huzi-ctrl/Verticality/TEACHER_REQUISITION.md

# School Purchase Requisition: CanSat Mission Components

**Project:** CanSat High-Altitude Scientific Investigation (Dual-Chamber Bioluminescence Experiment)  
**Student Name:** CanSat Project Lead  
**Institution:** Lancaster University School of Mathematics (LUSoM) Lab & D&T Department  
**Purpose:** Requisition for live biological science payload and flight electronics/hardware (excluding custom PCB fabrication).

---

## 1. Summary of Orders for School Approval

| Order | Supplier | Items Included | Total (ex. VAT) | Total (inc. VAT & Delivery) |
| :--- | :--- | :--- | :---: | :---: |
| **Order A** | **Darwin Biological UK** | Living *Pyrocystis* Algae Starter Culture + Marine Growth Medium Vial | **£32.50** | **£39.00** |
| **Order B** *(Option 1)* | **LCSC Electronics** | 7 Hand-Fit Electronics (LoRa Radio, 3.3V LDO, Battery Headers, Antenna, Switch, Heater) | **£18.41** | **£22.09** |
| **Order B** *(Option 2)* | **UK Hardware / Amazon** | Mechanical Airframe & Parachute Recovery (M3 Tie-Rods, Lifting Eye Bolt, Parachute Fabric, Swivels, Servo) | **£22.78** | **£22.78** |

*Note for School Finance: UK educational institutions reclaim VAT on educational/lab supplies (under Section 33 of the VAT Act 1994), so Darwin Biological net cost to the school department is £32.50.*

---

## Order A: Darwin Biological UK (Live Science Payload)
* **Supplier:** Darwin Biological UK ([darwinbiological.co.uk](https://www.darwinbiological.co.uk))
* **Supplier Type:** UK Educational & Laboratory Biology Supplier (accepts school purchase orders / card)
* **Delivery Method:** Temperature-controlled tracked living culture courier

### Itemized Breakdown:

| # | Item Description | Qty | Unit Price (ex. VAT) | Total Price (ex. VAT) | Direct Supplier Link |
| :-: | :--- | :-: | :-: | :-: | :--- |
| **1** | **Pyrocystis lunula Live Algae Starter Culture**<br>*Bioluminescent marine dinoflagellate algae in sterile culture flask. Primary test organism for measuring shear stress and gravity-induced luminescence response during flight.* | 1 | £17.85 | £17.85 | [Darwin Biological Direct Link](https://www.darwinbiological.co.uk/products/pyrocystis-lunula?variant=39852527976623) |
| **2** | **Marine Algae Growth Medium Vial (Makes 1 Litre)**<br>*Concentrated F/2 enrichment nutrient solution. Diluted into sterile seawater to maintain and culture the Pyrocystis stock in the school lab before and after the flight.* | 1 | £7.15 | £7.15 | [Darwin Biological Direct Link](https://www.darwinbiological.co.uk/products/marine-algae-growth-medium?variant=42611785892015) |
| **3** | **Live Culture Tracked Courier Delivery**<br>*Mandatory temperature-controlled tracked 24-hour delivery for live cultures.* | 1 | £7.50 | £7.50 | [Darwin Biological Checkout](https://www.darwinbiological.co.uk) |

* **Order A Subtotal (ex. VAT):** **£32.50**
* **20% UK VAT:** £6.50
* **Order A Grand Total (inc. VAT & Delivery):** **£39.00**

---

## Order B (Option 1): LCSC Electronics Basket (£22.09 Total)
* **Supplier:** LCSC Electronics ([lcsc.com](https://www.lcsc.com))
* **Purpose:** The 7 through-hole/hand-soldered electronics components that plug into the CanSat PCB for radio telemetry, power regulation, battery connection, and biological chamber thermal regulation.
* **Format:** Single basket with all items shipped together in one package.

### Itemized Breakdown:

| # | Item Description | Qty | Unit Price (GBP) | Total Price (GBP) | LCSC Part # | Direct Purchasing Link |
| :-: | :--- | :-: | :-: | :-: | :---: | :--- |
| **1** | **Ai-Thinker Ra-02 SX1278 433 MHz LoRa Radio Module**<br>*Long-range telemetry transmitter sending sensor data (altitude, temperature, light levels, acceleration) to ground station.* | 1 | £5.33 | £5.33 | `C90039` | [LCSC C90039](https://www.lcsc.com/product-detail/C90039.html) |
| **2** | **Microchip MCP1700-3302E/TO 3.3V 250mA LDO Regulator**<br>*Low-dropout TO-92 linear voltage regulator providing clean 3.3V power to the microcontroller and sensors.* | 1 | £0.81 | £0.81 | `C511277` | [LCSC C511277](https://www.lcsc.com/product-detail/C511277.html) |
| **3** | **100 µF 16V Radial Electrolytic Capacitor (D5×L7 mm)**<br>*Bulk buffer capacitor preventing voltage sag during servo deployment (pack of 50; spares remain in school lab).* | 50 | £0.015 | £0.74 | `C43803` | [LCSC C43803](https://www.lcsc.com/product-detail/C43803.html) |
| **4** | **JST-PH 2.0 mm 2-Pin Shrouded Male Battery Header**<br>*Standard polarity connector for plugging in 3.7V flight battery (pack of 20; spares remain in school lab).* | 20 | £0.027 | £0.54 | `C131337` | [LCSC C131337](https://www.lcsc.com/product-detail/C131337.html) |
| **5** | **BAT Wireless 433 MHz Helical Spring Antenna (21 mm)**<br>*Compact helical antenna fitting inside top compartment for 433 MHz transmission (pack of 5).* | 5 | £0.111 | £0.55 | `C496554` | [LCSC C496554](https://www.lcsc.com/product-detail/C496554.html) |
| **6** | **SOFNG SS-12D00-G3 Sub-Miniature SPDT Slide Switch**<br>*Master flight power hardware toggle switch.* | 1 | £0.02 | £0.02 | `C22355741` | [LCSC C22355741](https://www.lcsc.com/product-detail/C22355741.html) |
| **7** | **Yageo 15 Ω 2W 5% Metal Film Axial Power Resistor**<br>*Heating element glued to Chamber A block to maintain biology at +22°C during high-altitude descent (pack of 10).* | 10 | £0.042 | £0.42 | `C176558` | [LCSC C176558](https://lcsc.com/product-detail/Through-Hole-Resistors_YAGEO-MFR2WSJT-73-15R_C176558.html) |
| **8** | **Standard Courier Shipping Allowance** | 1 | £10.00 | £10.00 | — | Standard tracked shipping |
| **9** | **UK 20% VAT on LCSC Order** | 1 | £3.68 | £3.68 | — | 20% UK import VAT |

* **Order B (LCSC Option) Total inc. VAT & Delivery:** **£22.09**

---

## Order B (Option 2): UK Airframe & Parachute Hardware (£22.78 Total)
* **Suppliers:** Amazon UK & eBay UK
* **Purpose:** Physical structure tie-rods, parachute canopy fabric, rigging swivels, deployment servo, and thermal sensors (alternative £20–£25 order if the school prefers ordering through UK suppliers / Amazon rather than LCSC).

### Itemized Breakdown:

| # | Item Description | Qty | Unit Price (GBP) | Total Price (GBP) | Supplier | Direct Purchasing Link |
| :-: | :--- | :-: | :-: | :-: | :--- | :--- |
| **1** | **M3 × 300 mm A2 Stainless Steel Allthread Rods (Pack of 2)**<br>*Cut into 3× 115 mm structural tie-rods clamping the 3-tier CanSat PETG airframe together.* | 1 | £3.70 | £3.70 | Amazon UK | [Amazon UK Link](https://amzn.eu/d/0aMMNgs8) |
| **2** | **M3 A2 Stainless Steel Lifting Eye Bolt**<br>*Structural top anchor transferring parachute opening shock load directly to the 3 steel tie-rods.* | 1 | £2.15 | £2.15 | eBay UK | [eBay UK Link](https://www.ebay.co.uk/itm/323003622859) |
| **3** | **Ripstop Nylon Fabric 0.5 m × 1.5 m (Bright Orange)**<br>*Lightweight ripstop fabric to construct the 38 cm octo-annular parachute canopy.* | 1 | £3.15 | £3.15 | eBay UK | [eBay UK Link](https://www.ebay.co.uk/itm/124789110629) |
| **4** | **Heavy-Duty Ball-Bearing Swivels Size 2/4 (Pack of 10)**<br>*35 kg test breaking strain swivels preventing parachute shroud lines from twisting during descent.* | 1 | £3.39 | £3.39 | eBay UK | [eBay UK Link](https://www.ebay.co.uk/itm/122172655412) |
| **5** | **TowerPro MG90S Micro Metal-Gear 180° Servo**<br>*Actuator mechanism to release the 3 spring-loaded landing legs before touchdown.* | 1 | £3.31 | £3.31 | eBay UK | [eBay UK Link](https://www.ebay.co.uk/itm/188944133546) |
| **6** | **10k Ω NTC High-Precision Thin-Film Thermistors (Pack of 2)**<br>*Precision temperature probes monitoring Chamber A (heated) and Chamber B (unheated) biology.* | 1 | £1.99 | £1.99 | eBay UK | [eBay UK Link](https://www.ebay.co.uk/itm/172602710821) |
| **7** | **TP4056 USB-C 1A Lithium Battery Charging Board**<br>*Benchtop USB-C LiPo charger with dual protection ICs for safe battery recharging in the lab.* | 1 | £1.70 | £1.70 | eBay UK | [eBay UK Link](https://www.ebay.co.uk/itm/900026123899) |
| **8** | **IPEX / U.FL to Female SMA / Pigtail Coaxial RF Cable**<br>*RF pigtail connecting the Ra-02 LoRa board to the antenna (£1.39 + £2.00 Royal Mail delivery).* | 1 | £3.39 | £3.39 | eBay UK | [eBay UK Link](https://www.ebay.co.uk/itm/283186629071) |

* **Order B (UK Hardware Option) Total inc. VAT & Delivery:** **£22.78**

---

## 2. School Lab & Workshop Free Stock Provided (£0.00)
The following materials will be sourced directly from existing school D&T workshop and science lab supplies at no extra expense:
1. **Sterile Seawater Base:** School biology lab supply (distilled water + 35 g/L aquarium marine salt).
2. **Growth Light & 12:12 Timer:** Standard school laboratory fluorescent/LED grow lamp.
3. **Specimen Vials & Syringes:** 5 ml sterile polycarbonate sample vials and transfer pipettes.
4. **3D-Printing Filament:** PETG and TPU filament from school D&T 3D printers for the outer cylindrical hull and 3 landing legs.
5. **Fasteners:** M3 stainless steel Nyloc lock nuts and M3 washers from workshop stock.
6. **Recovery Cordage:** 550 military-spec paracord for parachute bridle and shroud lines.
7. **Ballast:** Scrap steel washers/nuts (~62 g) mounted in the lower battery hatch to position center of gravity below the leg pivot plane.
