huzi-ctrl/Verticality/images/pcb_angled_3d.png

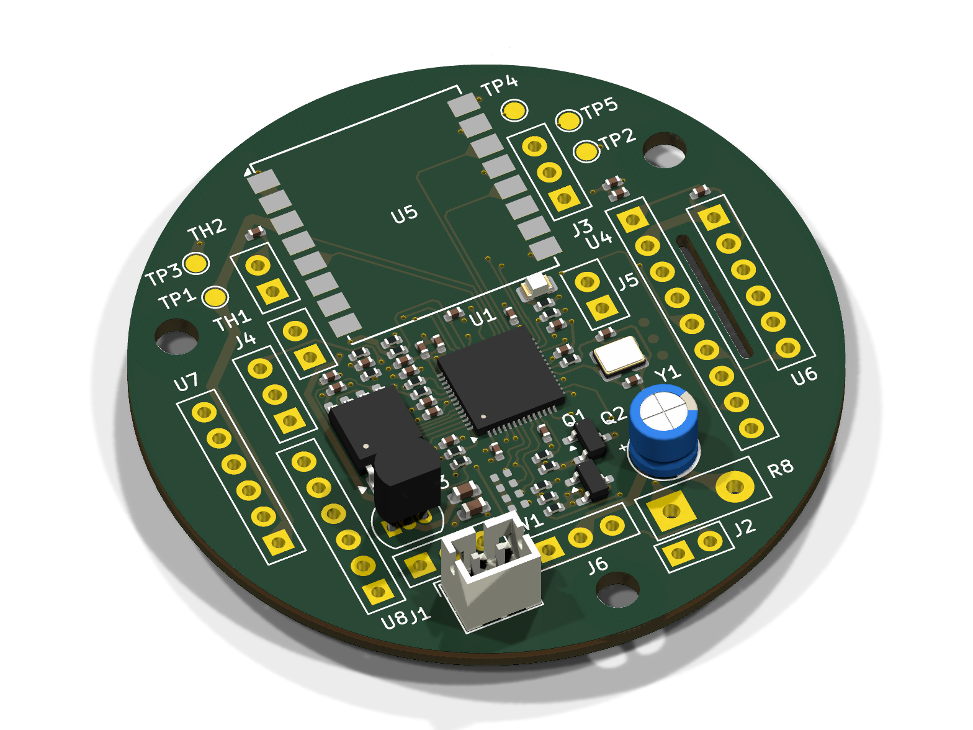
images/pcb_angled_3d.png
