huzi-ctrl/Verticality/images/pcb_bottom_3d.png

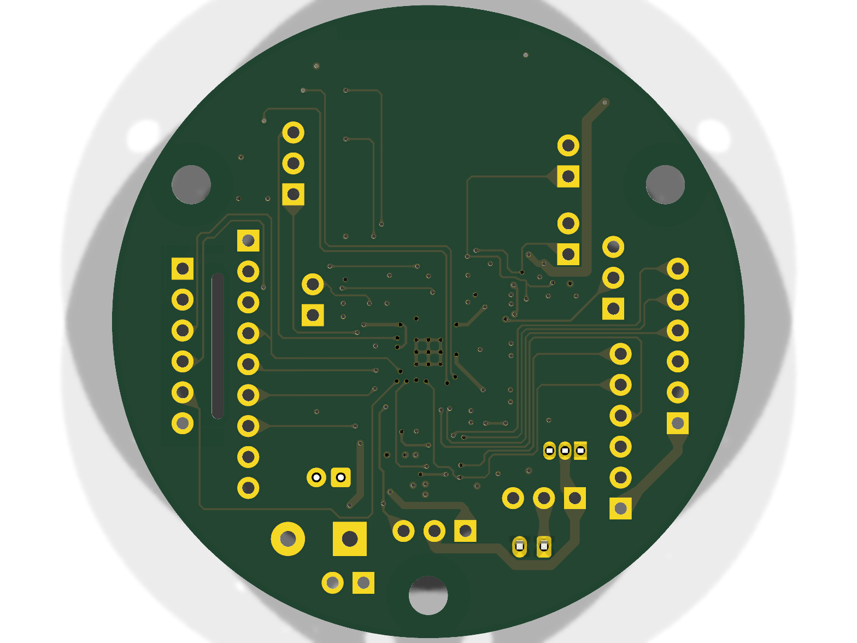
images/pcb_bottom_3d.png
