huzi-ctrl/Verticality/images/pcb_top_3d.png

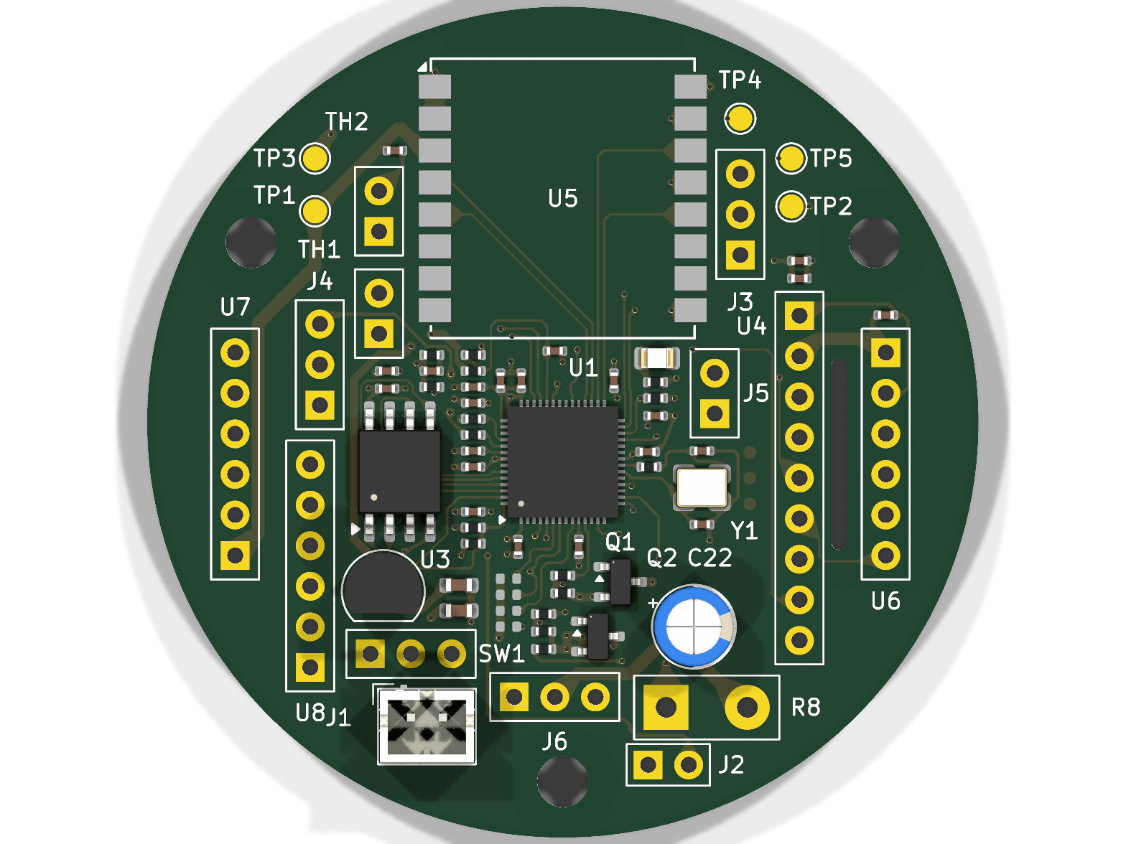
images/pcb_top_3d.png
