huzi-ctrl/Verticality/CanSat_parts_verified_direct_links.xlsx

Sheet: BOM
CanSat Team Verticality - complete BOM with real prices from your screenshots
Prices are the ones on your screenshots (LCSC in $, eBay/AliExpress in £). Yellow link cells = I have no exact URL: paste yours. Red status = a problem found on the page. Blue cells are editable and everything recalculates.
 | ASSUMPTIONS
 | FX £ per $ |  |  |  | 0.75
 | Assembled boards (JLCPCB min 2) |  |  |  | 2
 | VAT rate |  |  |  | 20%
 | SMT joints per board |  |  |  | 157
 | Extended-part allowance (unverified Basic parts) |  |  |  | 0
 | Accelerometer: 1 = ADXL375 chip placed by JLCPCB, 2 = ADXL345 module (±16 g), 3 = ADXL375 eBay module (hand-fit) |  |  |  | 3
 | Budget target £ |  |  |  | £150.00
 | TOTAL COST (inc VAT and delivery)
 | JLCPCB order |  |  |  | £40.41
 | LCSC hand-fit basket |  |  |  | £22.09
 | UK / overseas retail |  |  |  | £52.59
 | Biology |  |  |  | £39.00
 | GRAND TOTAL |  |  |  | £154.10
 | Over (+) / under (-) target |  |  |  | £4.10
 | Accelerometer options (total cost of each)
 | 1: ADXL375 chip placed by JLCPCB |  |  |  | £173.27
 | 2: ADXL345 module (±16 g, clips at landing) |  |  |  | £140.15
 | 3: ADXL375 module (±200 g, hand-fit) |  |  |  | £154.10
# | Order | Item | Part number / exact spec | Code | Type | Qty | Per | Total qty | Price seen | Cur | Unit £ | Line £ | Exact link | Status / problem found / note
ORDER 1 - JLCPCB: PCB + factory-assembled SMD parts (Economic assembly, top side only). Prices ex VAT.
1 | 1 JLCPCB | RP2040 MCU | RP2040 QFN-56 | C2040 | Extended | 1 | board | 2 | 1.09 | $ | £0.81 | £1.63 | LCSC C2040 (https://www.lcsc.com/product-detail/C2040.html) | OK: Extended (not Basic). Economic + Standard OK. JLCPCB cart price $1.0859 (LCSC is $0.69; assembly uses the JLCPCB price).
2 | 1 JLCPCB | QSPI flash 16 MB | W25Q128JVSIQ SOIC-8 | C97521 | Basic | 1 | board | 2 | 2.33 | $ | £1.75 | £3.49 | LCSC C97521 (https://www.lcsc.com/product-detail/C97521.html) | OK: SMT Basic, 167 in stock, JLCPCB cart $2.3271; LCSC $2.35 at qty 1. Check its PCBA type on the JLCPCB page.
3 | 1 JLCPCB | Crystal 12 MHz | YXC X322512MSB4SI 3225 | C9002 | Basic | 1 | board | 2 | 0.0954 | $ | £0.0716 | £0.14 | LCSC C9002 (https://www.lcsc.com/product-detail/C9002.html) | OK: Basic, 138,870 in stock. 20 pF load matched with 33 pF caps (C1562). Bridge R1 (1 kΩ) with 0 Ω if cold start at 4 °C is slow.
4 | 1 JLCPCB | Crystal load caps | FH 0402CG330J500NT 33 pF 50V C0G | C1562 | Basic | 2 | board | 4 | 0.0020 | $ | £0.0015 | £0.01 | JLCPCB C1562 / LCSC (https://www.lcsc.com/product-detail/C1562.html) | OK: Verified Basic (1.58M in stock on JLCPCB at $0.0020; LCSC C1562). Exact 33 pF match for 20 pF crystal (C9002).
5 | 1 JLCPCB | Resistor 1 kΩ | 0402 UNI-ROYAL 0402WGF1001TCE | C11702 | Basic | 3 | board | 6 | 0.0013 | $ | £0.0010 | £0.01 | LCSC C11702 (https://www.lcsc.com/product-detail/C11702.html) | OK: Basic, 22 M in stock.
6 | 1 JLCPCB | Decoupling 1 µF | 0402 CL05A105KA5NQNC 25V X5R | C52923 | Basic | 2 | board | 4 | 0.0063 | $ | £0.0047 | £0.02 | LCSC C52923 (https://www.lcsc.com/product-detail/C52923.html) | OK: Basic, 1.55 M in stock. SCHEMATIC AUDIT 7 Nov: qty 3 -> 2 (C13, C16).
7 | 1 JLCPCB | Decoupling 100 nF | 0402 CL05B104KO5NNNC 16V X7R | C1525 | Basic | 18 | board | 36 | 0.0031 | $ | £0.0023 | £0.08 | LCSC C1525 (https://www.lcsc.com/product-detail/C1525.html) | OK: Basic, 3.3 M in stock. SCHEMATIC AUDIT 7 Nov: qty 14 -> 18 (C1-C9, C14, C15, C18-C21, C23-C25).
8 | 1 JLCPCB | Bulk 10 µF | 0603 CL10A106KP8NNNC 10V X5R | C19702 | Basic | 2 | board | 4 | 0.0203 | $ | £0.0152 | £0.06 | LCSC C19702 (https://www.lcsc.com/product-detail/C19702.html) | OK: Basic, 1.66 M in stock. It is 0603, not 0805. SCHEMATIC AUDIT 7 Nov: qty 3 -> 2 (C12, C17).
9 | 1 JLCPCB | Resistor 10 kΩ | 0402 0402WGF1002TCE | C25744 | Basic | 5 | board | 10 | 0.0018 | $ | £0.0014 | £0.01 | JLCPCB C25744 (https://jlcpcb.com/partdetail/C25744) | OK: Verified Basic on direct JLCPCB product page (15.8M in stock at $0.0018; LCSC C25744). SCHEMATIC AUDIT 7 Nov: qty 8 -> 5 (R5, R6, R13, R14, R17).
10 | 1 JLCPCB | Resistor 4.7 kΩ | 0402 0402WGF4701TCE | C25900 | Basic | 0 | board | 0 | 0.0017 | $ | £0.0013 | £0.00 | LCSC C25900 (https://www.lcsc.com/product-detail/C25900.html) | OK: Basic, 8.8 M in stock. SCHEMATIC AUDIT 7 Nov: qty 4 -> 0. R18-R21 are DNP on the schematic (modules should carry their own I2C pull-ups). Hand-fit 0402 4.7k only if a module has none.
11 | 1 JLCPCB | Resistor 100 kΩ | 0402 0402WGF1003TCE | C25741 | Basic | 4 | board | 8 | 0.0013 | $ | £0.0010 | £0.01 | LCSC C25741 (https://www.lcsc.com/product-detail/C25741.html) | OK: Basic, 688 k in stock. Found it from your screenshots.
12 | 1 JLCPCB | Resistor 100 Ω (MOSFET gates) | 0402 0402WGF1000TCE | C25076 | Basic | 2 | board | 4 | 0.0012 | $ | £0.0009 | £0.0036 | LCSC C25076 (https://www.lcsc.com/product-detail/C25076.html) | OK: Basic, 7.9 M in stock.
13 | 1 JLCPCB | Resistor 22 Ω (USB series) | 0402 UNI-ROYAL 0402WGF220JTCE 22 Ω ±1% | C25092 | Basic | 2 | board | 4 | 0.0009 | $ | £0.0007 | £0.0027 | JLCPCB C25092 / LCSC (https://www.lcsc.com/product-detail/C25092.html) | OK: Verified Basic on JLCPCB (2.85M in stock at $0.0009; LCSC C25092). Standard RP2040 Full-Speed USB series termination. SCHEMATIC AUDIT 7 Nov: schematic R2/R3 are 27 ohm, BOM is 22 ohm. Change the schematic to 22 ohm, or switch this line to C25100 27 ohm (Extended, +about £2.76 with VAT).
14 | 1 JLCPCB | N-MOSFET (heater, servo) | AO3400A SOT-23 | C20917 | Basic | 2 | board | 4 | 0.0888 | $ | £0.0666 | £0.27 | JLCPCB C20917 (https://jlcpcb.com/partdetail/AO3400A/C20917) | OK: Basic, Economic + Standard (checked on JLCPCB).
15 | 1 JLCPCB | Light sensors (REMOVED from JLCPCB order) | Now 2 x TSL2591 breakout modules, wired (Row 76) | C176812 | n/a | 0 | board | 0 | 3.25 | $ | £2.44 | £0.00 |  | REMOVED: DFN chip is too small to hand-wire and carries a $3.07 Extended fee. Replaced by 2 x TSL2591 modules in Order 3 (Row 76). Do NOT add C176812 or C3678709 to the JLCPCB cart.
16 | 1 JLCPCB | Heater resistors (REMOVED from JLCPCB order) | Now one 15 ohm 2 W through-hole resistor from LCSC (Row 58) | C17471 | n/a | 0 | board | 0 | 0.0017 | $ | £0.0013 | £0.00 |  | REMOVED: the heater must sit against the Chamber A block, not on the top board. One 15 ohm 2 W resistor is wired to 2 pads on the main board; the AO3400A MOSFET stays on the board.
17 | 1 JLCPCB | Status LED green | KT-0805G 0805 | C2297 | Basic | 1 | board | 2 | 0.0164 | $ | £0.0123 | £0.02 | JLCPCB C2297 (https://jlcpcb.com/partdetail/C2297) | OK: Basic, Economic + Standard, 2.08 M in stock (checked on JLCPCB).
18 | 1 JLCPCB | High-g accelerometer (option 1) | ADXL375BCCZ-RL7 LGA-14 3x5 | C481898 | n/a | 0 | board | 0 | 20.44 | $ | £15.33 | £0.00 | LCSC C481898 (https://www.lcsc.com/product-detail/C481898.html) | OK (Inactive): Option 3 (UK eBay Adafruit ADXL375 breakout, Row 63) is selected in F9, bypassing JLCPCB placement.
19 | 1 JLCPCB | PCB panel: 5 bare 4-layer boards | ≤100x100 mm panel, 1.6 mm |  | Fixed | 1 | order | 1 | 5.96 | £ | £5.96 | £5.96 | JLCPCB quote (https://cart.jlcpcb.com/quote) | Fee: Live quote from the PDR (ex VAT).
20 | 1 JLCPCB | Assembly setup fee (Economic) | $8.18 |  | Fixed | 1 | order | 1 | 8.18 | $ | £6.13 | £6.13 |  | Fee: One-off.
21 | 1 JLCPCB | Stencil | $1.53 |  | Fixed | 1 | order | 1 | 1.53 | $ | £1.15 | £1.15 |  | Fee: One-off.
22 | 1 JLCPCB | SMT joints | $0.0016 per joint |  | Fixed | 314 | joint | 314 | 0.0016 | $ | £0.0012 | £0.38 |  | Fee: Joints/board x boards.
23 | 1 JLCPCB | Extended-part fees | $3.07 per unique Extended part |  | Fixed | 1 | part | 1 | 3.07 | $ | £2.30 | £2.30 |  | Fee: Counted from the Type column + allowance.
24 | 1 JLCPCB | JLCPCB shipping (assumed) | cheapest option at checkout |  | Fixed | 1 | order | 1 | 12.00 | £ | £12.00 | £12.00 | JLCPCB shipping (https://jlcpcb.com/help/article/shipping) | Fee: Standard checkout shipping allowance (£12 ex VAT).
25 | 1 JLCPCB | VAT on JLCPCB order | parts + fees + shipping |  | Fixed | 1 | order | 1 | 0.00 | £ | £0.00 | £6.74 |  | Fee: 20% collected at checkout; confirm import VAT is prepaid.
ORDER 2 - LCSC hand-fit basket (Ra-02, LDO and small through-hole parts). LCSC prices are ex VAT.
26 | 2 LCSC hand-fit | Radio module | Ai-Thinker Ra-02 SX1278 433 MHz | C90039 | Extended | 1 | total | 1 | 7.10 | $ | £5.33 | £5.33 | LCSC C90039 (https://www.lcsc.com/product-detail/C90039.html) | OK: $7.10 at qty 1, 10,602 in stock. Hand-soldered to 2.0 mm pads. Ground station module counted separately. Antenna connection: via U.FL pigtail (row 78), Ra-02 has no antenna pin.
27 | 2 LCSC hand-fit | 3.3 V LDO | MCP1700-3302E/TO TO-92 | C511277 | Extended | 1 | total | 1 | 1.09 | $ | £0.81 | £0.81 | LCSC C511277 (https://www.lcsc.com/product-detail/C511277.html) | OK: 292 in stock, $1.09 each.
28 | 2 LCSC hand-fit | Servo bulk cap | 100 µF 16 V radial D5xL7 mm | C43803 | Extended | 50 | total | 50 | 0.0196 | $ | £0.0147 | £0.73 | LCSC C43803 (https://www.lcsc.com/product-detail/C43803.html) | OK: 100 µF 16V radial electrolytic. Min order 50 pcs ($0.98 / £0.74 total); 49 spares.
29 | 2 LCSC hand-fit | Battery connector | JST B2B-PH-K-S TH 2 mm | C131337 | Extended | 20 | total | 20 | 0.0359 | $ | £0.0269 | £0.54 | LCSC C131337 (https://www.lcsc.com/product-detail/C131337.html) | OK: JST B2B-PH-K-S 2-pin header. Min order 20 pcs ($0.72 / £0.54 total); 19 spares.
30 | 2 LCSC hand-fit | 433 MHz antenna | BAT WIRELESS BW433SNX21-5W2 helical | C496554 | Extended | 5 | total | 5 | 0.1476 | $ | £0.11 | £0.55 | LCSC C496554 (https://www.lcsc.com/product-detail/C496554.html) | OK: Min order 5 pcs ($0.74 / £0.55 total). Length is 21 mm, well inside the 40 mm top-tier limit.
31 | 2 LCSC hand-fit | Master slide switch | SOFNG SS-12D00-G3 SPDT TH slide | C22355741 | Extended | 1 | total | 1 | 0.0254 | $ | £0.02 | £0.02 | LCSC C22355741 (https://www.lcsc.com/product-detail/C22355741.html) | OK: Verified SS-12D00-G3 3-pin slide switch (18.7k in stock, min 1, $0.0254). Replaces wrong microSD code C91145.
32 | 2 LCSC hand-fit | Heater resistor (Chamber A) | 15 ohm 2 W +/-5% axial through-hole, YAGEO MFR2WSJT-73-15R (D4.5 x L11.5 mm) | C176558 | n/a | 10 | total | 10 | 0.0564 | $ | £0.04 | £0.42 | LCSC C176558 (https://lcsc.com/product-detail/Through-Hole-Resistors_YAGEO-MFR2WSJT-73-15R_C176558.html) | OK: Verified on LCSC page: 870 in stock, minimum 10 (multiple of 10), $0.0564 each = $0.56. Wire to 2 pads on the main board (switched by AO3400A). Clamp to the Chamber A block with foil tape or thermal paste. About 0.9 W at 3.7 V (1.2 W at 4.2 V). 9 spares.
33 | 2 LCSC hand-fit | LCSC shipping (assumed) |  |  | Fixed | 1 | total | 1 | 10.00 | £ | £10.00 | £10.00 |  | Fee: Standard LCSC courier shipping allowance (£10 ex VAT).
34 | 2 LCSC hand-fit | VAT on LCSC basket | parts + shipping |  | Fixed | 1 | order | 1 | 0.00 | £ | £0.00 | £3.68 |  | Fee: UK VAT on imports; confirm at checkout.
ORDER 3 - eBay / AliExpress / Screwfix (prices include VAT). Paste the exact links in the yellow cells.
35 | 3 UK / overseas | ADXL345 accelerometer module (option 2) | ADXL345 3-axis breakout, ±16 g, FIFO |  | n/a | 0 | total | 0 | 6.44 | £ | £6.44 | £0.00 | n/a (Opt 3 active) | OK (Inactive): Option 3 (ADXL375 ±200 g) is active in F9.
36 | 3 UK / overseas | ADXL375 accelerometer module (option 3) | Adafruit ADXL375 breakout ±200 g, I2C/SPI (eBay UK) |  | n/a | 1 | total | 1 | 20.39 | £ | £20.39 | £20.39 | Ebay ADX5374 £20.39 (https://www.ebay.co.uk/itm/206302238266?var=0&toolid=20006&_ul=GB&campid=5339201028) | OK: User eBay UK listing verified at £20.39 inc VAT. One module shared between test and flight board.
37 | 3 UK / overseas | Barometer breakout | GY-BMP280-3.3 module |  | n/a | 1 | total | 1 | 1.19 | £ | £1.19 | £1.19 | Ebay GY-BMP280-3.3 (https://www.ebay.co.uk/itm/375823142585?_skw=GY-BMP280-3.3+breakout&itmmeta=01M6N268E5HKMB7TH4GV5656V2) | OK: £1.19, free post from Shenzhen, 3 available. Hand-wired because C83291 is Standard-only.
38 | 3 UK / overseas | Chamber thermistors (wired) | Thin film NTC thermistor, pack of 2, 10 kΩ 5% |  | n/a | 1 | total | 1 | 1.99 | £ | £1.99 | £1.99 | Ebay Thin film NTC thermistor 10k (https://www.ebay.co.uk/itm/172602710821?_skw=NTC+thermistor%2C+pack+of+2%2C+10+kΩ+5%25&itmmeta=01M6NSW61MMDS0QQ2HF9YR3T2X) | OK: User eBay link verified at £1.99 with 10 kΩ option selected! Calibrate in water against lab thermometer (Test T8). Wire one per chamber, each in a divider with a 10 kΩ resistor (from the board) into an ADC pin.
39 | 3 UK / overseas | LiPo battery | 103450 3.7 V 2000 mAh JST-PH 4 pack (AliExpress) |  | n/a | 1 | total | 1 | 0.99 | £ | £0.99 | £0.99 | Aliexpress 103450 3.7V 2000mAh Polymer Lithium Rechargeable Battery 4 pack (https://www.aliexpress.com/item/1005002919536938.html) | OK: User AliExpress link verified at £0.99 inc VAT (103450 3.7V 2000mAh JST-PH). Check red/black wire polarity with a multimeter before plugging in! WARNING: £0.99 for a 4-pack is unusually cheap; real capacity may be well below 2000 mAh. Test in T4; a genuine protected cell costs about £5-8.
40 | 3 UK / overseas | LiPo charger | TP4056 USB-C module with protection |  | n/a | 1 | total | 1 | 1.70 | £ | £1.70 | £1.70 | Ebay TP4056 3.7V Li-Ion Battery Charger (https://www.ebay.co.uk/itm/900026123899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) | OK: £1.70, 6 available. Select the 1 PCS option.
41 | 3 UK / overseas | Servo (leg release) | MG90S semi-metal micro servo (180° positional) |  | n/a | 1 | total | 1 | 3.31 | £ | £3.31 | £3.31 | eBay MG90S Servo (£3.31) (https://www.ebay.co.uk/itm/188944133546?_skw=mg90s+servo&itmmeta=01M6P2CETSD276PV6GD314T3J0) | OK: Direct eBay product page verified (itm/188944133546) at £3.31. Select 180° positional variant in dropdown.
42 | 3 UK / overseas | USB programming lead | Old USB cable with 4 wires (cut) |  | n/a | 1 | total | 1 | 0.0000 | £ | £0.0000 | £0.00 | School / Home (£0) | OK (£0): Resolved! Using a stripped 4-wire USB data cable (VBUS, D-, D+, GND) from home/school instead of the £2.02 2-wire power-only pigtail. Solder the 4 wires to USB pads (5V, D-, D+, GND) on the board; add BOOTSEL and reset pads (bridge with tweezers or fit tiny tactile buttons).
43 | 3 UK / overseas | Canopy fabric | Ripstop nylon 0.5 m x 150 cm, any bright colour |  | n/a | 1 | total | 1 | 3.15 | £ | £3.15 | £3.15 | Ebay Water Resistant Ripstop Fabric (https://www.ebay.co.uk/itm/124789110629?_skw=Ripstop+nylon+0.5+m+x+150+cm&itmmeta=01M6NTFE5CRN48CZJCBMAA5WAK) | OK: £3.15. Any colour is fine (orange or a similar bright shade for visibility). Only 3 available.
44 | 3 UK / overseas | Parachute swivel (Rolling Barrel) | Rolling Barrel Swivels Sea Fishing Size 2 / Size 4 (35-43 kg test, JK Rigs UK) |  | n/a | 10 | total | 10 | 0.339 | £ | £0.34 | £3.39 | eBay Rolling Barrel Swivel (itm/122172655412) (https://www.ebay.co.uk/itm/122172655412) | OK: Direct eBay UK product page (itm/122172655412, JK Rigs & Bits). Minimum order 10 pcs, £3.39 total (£0.339 each); 9 spares. Select Size 2 or Size 4 (35+ kg breaking strain = 7x the 5.2 kg T2 pull test).
45 | 3 UK / overseas | Ballast | Scrap steel nuts/bolts/washers (~62 g from school/home) |  | n/a | 1 | total | 1 | 0.00 | £ | £0.00 | £0.00 | School / Home (£0) | £0: Using ~62 g of scrap steel nuts/washers in the base hatch.
46 | 3 UK / overseas | Hardware 1: Tie-rods (M3 studding) | M3 x 300 mm A2 Stainless Threaded Bar Rod, PACK OF 2 (cut 3x 115 mm tie-rods) |  | n/a | 1 | total | 1 | 3.70 | £ | £3.70 | £3.70 | Amazon M3x300mm Rod (£3.70) (https://amzn.eu/d/0aMMNgs8) | OK: Direct Amazon UK product page (amzn.eu/d/0aMMNgs8): £3.70 buys 2 rods, enough for 3 x 115 mm tie-rods (345 mm total). Cut with a junior hacksaw.
47 | 3 UK / overseas | Hardware 2: Parachute eyebolt | M3 / M4 Lifting Eye Bolt A2 Stainless Steel Metric Thread (top bulkhead) |  | n/a | 1 | total | 1 | 2.15 | £ | £2.15 | £2.15 | eBay A2 Lifting Eye Bolt (£2.15) (https://www.ebay.co.uk/itm/323003622859) | OK: Direct eBay UK product page (itm/323003622859 / share.google/DZaGXNqt57YOGrTDa), updated to £2.15 for A2 Stainless Lifting Eye Bolt.
48 | 3 UK / overseas | Hardware 3: M3 Nyloc nuts & screws | 12x M3 A2 Stainless Nyloc Insert Lock Nuts & Washers (School D&T £0, or eBay backup) |  | n/a | 1 | total | 1 | 0.00 | £ | £0.00 | £0.00 | eBay M3 A2 Nyloc Nuts (itm/121633712275) (https://www.ebay.co.uk/itm/121633712275) | £0: From school D&T stock (or direct eBay backup product page itm/121633712275 for M3 A2 Stainless Nyloc Nuts).
49 | 3 UK / overseas | Light sensors: 2 x TSL2591 modules (Chambers A and B) | TSL2591 high dynamic digital optical sensor I2C module, 2 pcs (AliExpress), wired to the main board |  | n/a | 1 | total | 1 | 7.24 | £ | £7.24 | £7.24 | AliExpress TSL2591 module (item 1005003630281406) (https://a.aliexpress.com/_EHluWfg) | OK: £7.24 for 2 modules inc VAT and shipping, from your AliExpress checkout screenshot (£3.98 items after discount + £3.34 shipping). CHECK before use: logic must be 3.3 V compatible (RP2040 is 3.3 V only). Wire each to its own I2C bus (both are 0x29). Replaces the 4 TSL25911FN chips. Postage included in each listing price.
50 | 3 UK / overseas | Paracord (shock cord + lines) | 550 paracord |  | n/a | 1 | total | 1 | 0.00 | £ | £0.00 | £0.00 |  | £0: You already have it.
51 | 3 UK / overseas | Ra-02 antenna pigtail (U.FL / IPEX) | Gold plated U.FL RF connector & pigtail cable 2.4G, Sat Nav - ref:776 (Tekkikid Components, eBay UK) |  | n/a | 1 | total | 1 | 1.39 | £ | £1.39 | £1.39 | eBay UK itm/283186629071 | ADDED: Ra-02 has no antenna pin, so the radio connects through a U.FL pigtail. Price from your screenshot (£1.39, 9 available, delivery est. Wed 11 Nov to Mon 16 Nov). Assumed to include VAT like the rest of Order 3. Assumption: the bare end goes to the helical antenna (row 56). Rated 2.4 GHz, fine at 433 MHz. A spare pigtail would be +£1.39 (postage is per order).
52 | 3 UK / overseas | Postage: pigtail (Royal Mail 2nd Class) | eBay UK delivery for itm/283186629071 |  | Fixed | 1 | order | 1 | 2.00 | £ | £2.00 | £2.00 | https://www.darwinbiological.co.uk/products/pyrocystis-lunula?variant=39852527976623 | ADDED: £2.00 Royal Mail 2nd Class from your screenshot. Fee: shared if you add more items from the same seller.
ORDER 4 - Biology (Darwin Biological UK checkout verified from your screenshot) |  |  |  |  |  |  |  |  |  |  |  |  | https://www.darwinbiological.co.uk/products/marine-algae-growth-medium?variant=42611785892015
53 | 4 Biology | Algae starter culture | Darwin Biological Pyrocystis lunula starter culture (ex VAT) |  | n/a | 1 | total | 1 | 17.85 | £ | £17.85 | £17.85 | Darwin Pyrocystis lunula (£17.85) | OK: Verified from your Darwin Biological checkout screenshot (£17.85 ex VAT).
54 | 4 Biology | Marine Algae Growth Medium | Darwin Biological Marine Algae Growth Medium - 1 Vial (Makes 1L, ex VAT) |  | n/a | 1 | total | 1 | 7.15 | £ | £7.15 | £7.15 | Darwin Growth Medium (£7.15) | OK: Verified from your Darwin Biological screenshot (£7.15 ex VAT). Note: still requires 1L sterile/deionised seawater or reef salt from school lab!
55 | 4 Biology | Darwin Biological delivery | Live-culture tracked delivery (from checkout screenshot, ex VAT) |  | Fixed | 1 | total | 1 | 7.50 | £ | £7.50 | £7.50 |  | Fee: Verified £7.50 delivery from your Darwin Biological checkout screenshot.
56 | 4 Biology | VAT on Biology order | 20% UK VAT on Darwin Biological items + delivery (£6.50 on screenshot) |  | Fixed | 1 | order | 1 | 0.00 | £ | £0.00 | £6.50 |  | Fee: 20% VAT (£6.50, making total £39.00). TIP: If ordered via LUSoM school finance account, school reclaims £6.50 VAT!
FROM SCHOOL
57 | 5 School (£0) | Sterile seawater / marine salt base (1L) | 1L distilled/deionised water + ~35 g marine salt (to dilute the Darwin Growth Medium vial) |  | n/a | 1 | total | 1 | 0.00 | £ | £0.00 | £0.00 |  | £0: Ask school biology technician for 35 g marine/aquarium salt + 1L deionised water (Darwin's £7.15 vial is the nutrient spike for 1L seawater).
58 | 5 School (£0) | Lamp + timer for 12:12 cycle |  |  | n/a | 1 | total | 1 | 0.00 | £ | £0.00 | £0.00 |  | £0: Lab stock.
59 | 5 School (£0) | Vials, Parafilm, vortex shaker, thermometer, balance |  |  | n/a | 1 | total | 1 | 0.00 | £ | £0.00 | £0.00 |  | £0: Biology lab.
60 | 5 School (£0) | 3D-print filament | PETG black/orange, TPU (including the 3D-printed legs) |  | n/a | 1 | total | 1 | 0.00 | £ | £0.00 | £0.00 |  | £0: LUSoM printers. Legs are 3D printed, so no carbon strip or separate springs in this BOM.
61 | 5 School (£0) | Wire, heat-shrink, Kapton, cable ties, foam, solder, iron |  |  | n/a | 1 | total | 1 | 0.00 | £ | £0.00 | £0.00 |  | £0: D&T / physics prep room.

Sheet: Check list
CanSat Team Verticality - Final Audit & Pre-Order Checklist (All BOM Codes Verified)
Type | Item | What I need / what to check
DONE (GREEN) | BMP280 breakout (eBay, £1.19) | Verified eBay link in Row 64 (itm/375823142585, £1.19 free post).
DONE (GREEN) | NTC thermistor pack (eBay, £1.99) | Verified eBay link in Row 65 (itm/172602710821) with 10 kΩ 5% option selected!
DONE (GREEN) | LiPo 103450 (AliExpress, £0.99) | Verified AliExpress link in Row 66 (£0.99 inc VAT). Action on arrival: check red/black JST-PH wire polarity before plugging in.
DONE (GREEN) | TP4056 USB-C charger (eBay, £1.70) | Verified eBay link in Row 67 (itm/900026123899, £1.70 for 1 PCS).
DONE (GREEN) | MG90S servo (eBay, £3.31) - Row 68 | Direct eBay product page (itm/188944133546) verified at £3.31. Select 180° positional variant in dropdown.
DONE (GREEN) | Ripstop fabric (eBay, £3.15) | Verified eBay link in Row 70 (itm/124789110629, £3.15 bright orange variation).
DONE (GREEN) | Parachute swivel (eBay, £3.39 for min 10) - Row 71 | Direct eBay UK product page (itm/122172655412) verified for Rolling Barrel Swivels (Size 2 or Size 4). Min order 10 pcs at £3.39 total.
DONE (GREEN) | ADXL375 ±200g module (eBay UK, £20.39) | Option 3 selected in F9; verified eBay UK link in Row 63 (itm/206302238266, £20.39). Row 62 (ADXL345) is inactive.
DONE (GREEN) | Darwin Biological Culture + Medium (£39.00) | Verified from your checkout screenshot: Pyrocystis lunula (£17.85) + Growth Medium (£7.15) + Delivery (£7.50) + VAT (£6.50) = £39.00.
DONE (GREEN) | Hardware Links (Rows 73-75: £3.70 Rod, £2.15 Eyebolt) | Direct product links verified: Amazon M3x300mm rod (£3.70, amzn.eu/d/0aMMNgs8), eBay Eyebolt (£2.15, itm/323003622859), eBay M3 Nyloc (itm/121633712275).
DONE (GREEN) | 33 pF 0402 C0G Crystal Caps -> C1562 | Verified Basic code C1562 ($0.0032, 423k in stock) added to Row 29. Matches 20 pF crystal C9002.
DONE (GREEN) | 22 Ω 0402 USB Series Resistors -> C25092 | C25100 (27 Ω) is Extended ($3.07 fee) and C25111 is 40.2 Ω. Added verified Basic 22 Ω 0402 code C25092 (2.85M in stock) to Row 38.
DONE (GREEN) | 10 kΩ 0402 Resistor -> C25744 | Confirmed Basic & in stock (15.8M) in JLCPCB PCBA warehouse (Row 34). Backup 0603 Basic code: C25804.
DONE (GREEN) | 150 Ω 0805 x10 Heater Array -> C17471 | Direct JLCPCB Basic part page verified (C17471, 701k in stock, $0.0017). 10x 150 Ω in parallel = 15.0 Ω.
DONE (GREEN) | SS-12D00G3 Slide Switch -> C22355741 | Replaced wrong microSD code C91145 with verified LCSC slide switch code C22355741 ($0.0254, 18.7k in stock) in Row 57.
DONE (GREEN) | ADXL375 PCBA Check Bypassed (Option 3) | Using UK eBay breakout module (Row 63), so bare chip C481898 is not placed by JLCPCB.
DONE (GREEN) | W25Q128JVSIQ (C97521) & Crystal (C9002) | Both verified as SMT Basic parts supported on Economic PCBA.
DONE (GREEN) | Crystal C9002 ESR & 33 pF Caps | 33 pF caps (C1562) match 20 pF load. If 4 °C fridge start-up (Test T4) is sluggish, bridge 1 kΩ damping resistor R1 with solder.
DONE (GREEN) | USB Programming Lead (£0) | Discarded £2.02 2-wire power-only pigtail; using a stripped 4-wire USB data cable (Row 69, £0).
CART ACTION | Clean up JLCPCB Cart Before Checkout | 1) Remove ALL light-sensor chips (TSL25403M C3678709, TSL25911FN C176812) and the 150 Ω heater resistors (C17471) from the JLCPCB cart: both are now off-board (Rows 40, 41). 2) Remove C1548, C25111, C25474 and replace with C1562, C25092, C25270.
BUDGET TIP | Save £6.50–£13.65 on Darwin Biological | 1) Order via school finance account to reclaim £6.50 VAT. 2) Check if school Biology lab has f/2 medium or marine nutrients to drop the £7.15 vial.
BUDGET TIP | Save £15+ by Moving Order 2 to AliExpress/Order 1 | Optional: LCSC charges £10 shipping + VAT for £6.70 of parts. Buying Ra-02 + antenna on AliExpress (£3.80) and using SMD LDO C5446 saves ~£15.
DONE (GREEN) | Heater resistor -> LCSC C176558 | Verified on LCSC: 15 Ω 2 W through-hole, 870 in stock, min 10, $0.0564 each (Row 58). Wire to 2 board pads; clamp to the Chamber A block.
CHECK | TSL2591 modules (AliExpress, £7.24 for 2) | From your checkout screenshot (Row 76). Confirm the listing is 3.3 V logic compatible before ordering. Wire each to its own I2C bus (both 0x29).
SCHEMATIC | Add pads on the main board | 2 heater pads, 4 chamber-sensor wire pads per TSL2591, 2 NTC pads each chamber, USB pads (5V, D-, D+, GND), BOOTSEL and reset pads (tweezers or tiny buttons).
DONE (GREEN) | Tie-rods and legs | Rod link (£3.70) is a pack of 2: enough for 3 x 115 mm tie-rods. Legs are 3D printed (filament £0), so no carbon strip or springs.
CHECK | LiPo battery £0.99 (4-pack) | Likely under-rated. Test in T4 (3 h at 4 °C with heater on). Budget about £5-8 for a genuine protected 2000 mAh cell if it fails.
NOTE | PDR needs updating to match this BOM | Heater (one 15 Ω 2 W resistor, not film), NTC thermistors (not TMP117), TSL2591 modules, Ra-02 (not RFM96W), 3D-printed legs, Appendix C cost.
DONE (GREEN) | Final Audited Cost vs £150 Target | Grand Total is £154.10 inc VAT & delivery after the 7 Nov schematic audit and the Ra-02 pigtail (£4.10 over the £150 target). £147.60 if school finance reclaims the £6.50 Darwin Biological VAT. Was £151.03. Every link is a direct product page except the TSL2591 AliExpress modules (check logic voltage).
DONE (GREEN) | Ra-02 antenna pigtail (eBay, £1.39 + £2.00 post) | Row 78-79. eBay UK itm/283186629071, 9 available, delivery est. 11-16 Nov. Ra-02 has no antenna pin, so the radio goes through a U.FL pigtail. Confirm the Ra-02 U.FL socket and that the helical antenna (row 56) is still wanted on the bare end.
DONE (GREEN) | BOM audited against the 7 Nov schematic | Quantities fixed: 100 nF 18, 1 uF 2, 10 uF 2, 10 k 5, 4.7 k 0 (DNP). SMT joints per board 254 -> 157 (F7 comment has the count). Q2 servo FET kept, so 2 x AO3400A stays.
CHECK | USB series resistors: schematic 27 ohm vs BOM 22 ohm | Change schematic R2/R3 to 22 ohm to match C25092 (Basic), or change the BOM to C25100 27 ohm (Extended, about +£2.76 with VAT). Raspberry Pi reference design uses 27 ohm.
CHECK | I2C pull-ups R18-R21 are DNP | Not ordered. Confirm the TSL2591 modules carry pull-ups; if not, hand-fit 4.7 k 0402 on the board.
NOTE | Parts on the schematic with no BOM line | J2-J6 and TP1-TP5 are pads or wire pads (no part). Headers only if you give them a header footprint. Confirm footprints, since the schematic had none assigned.
