huzi-ctrl/Verticality/schematic.pdf

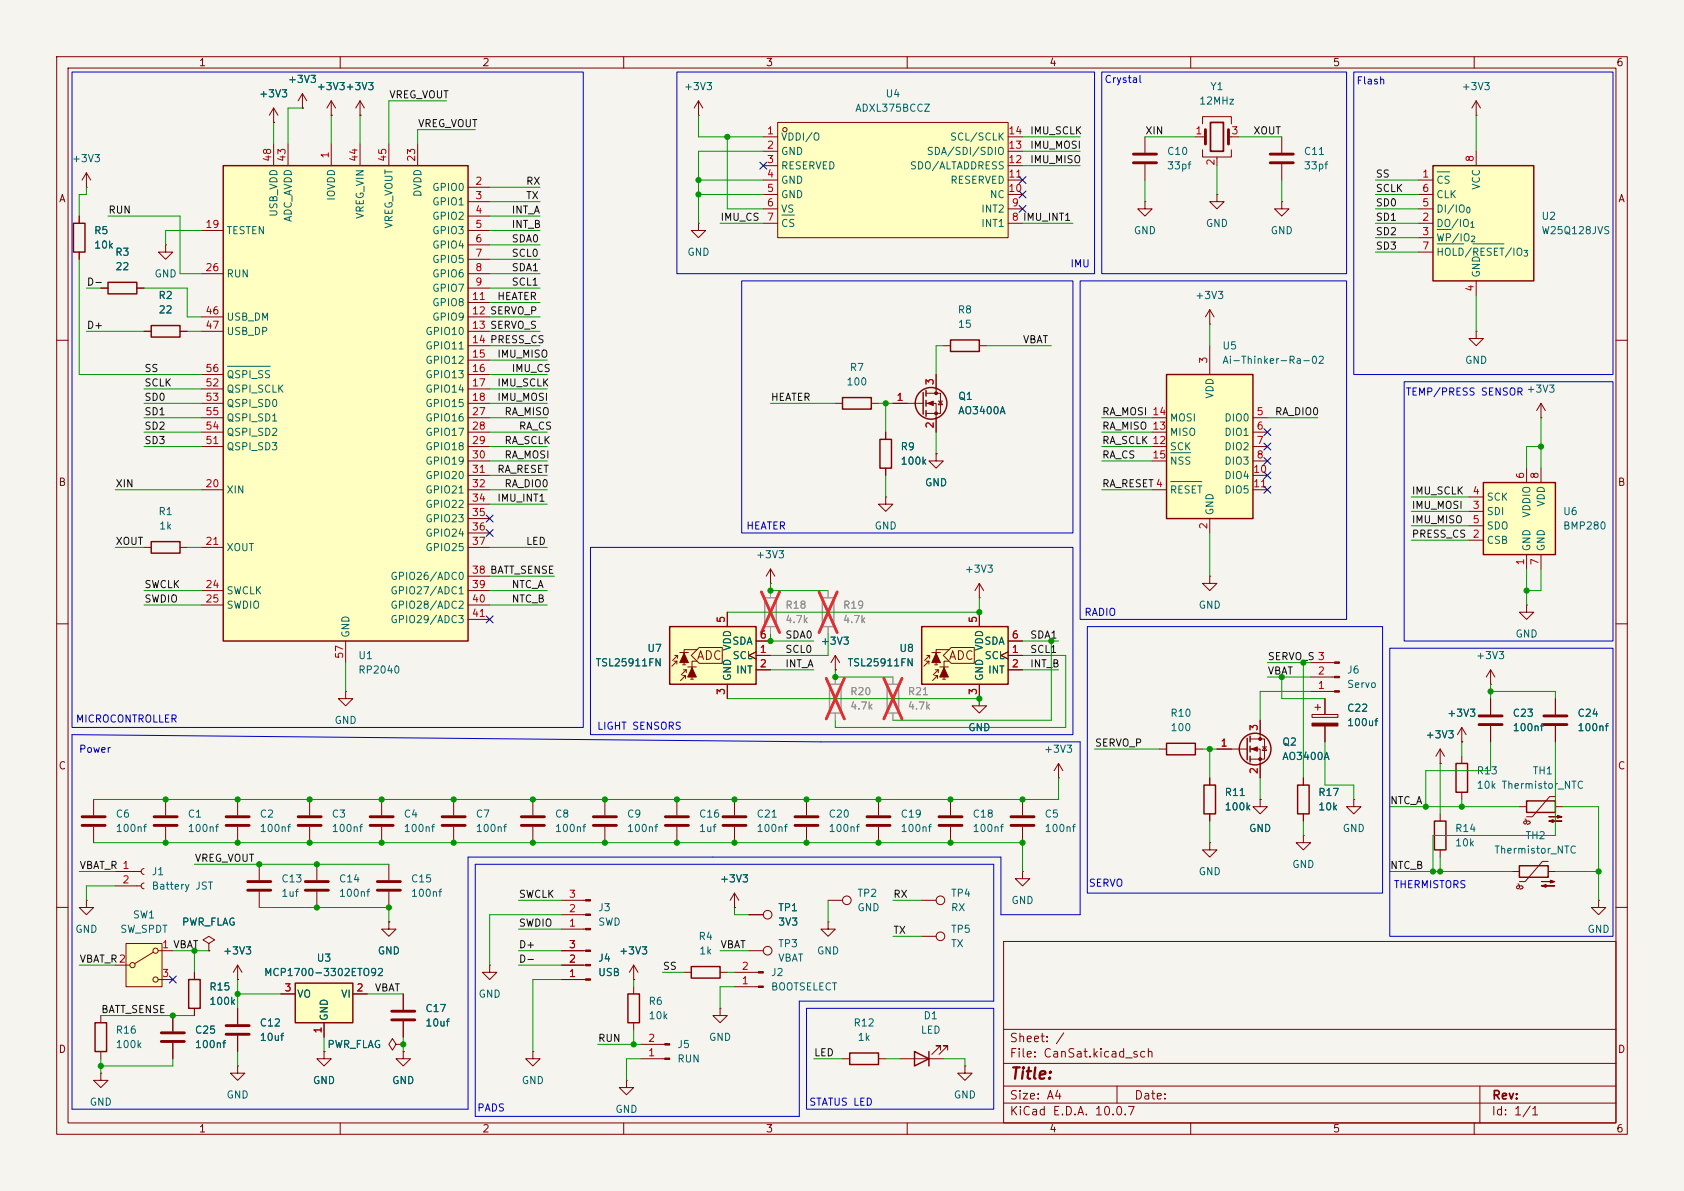
[picture p11: page 1]

4 DI/IO0 5 CLK 6 HOLD/RESET/IO3 7 VCC

Size: A4 | Rev:
KiCad E.D.A. 10.0.7 | Id: 1/1
