huzi-ctrl/Verticality/CanSat.kicad_pcb

## KiCad design CanSat.kicad_pcb (2026-11-08)

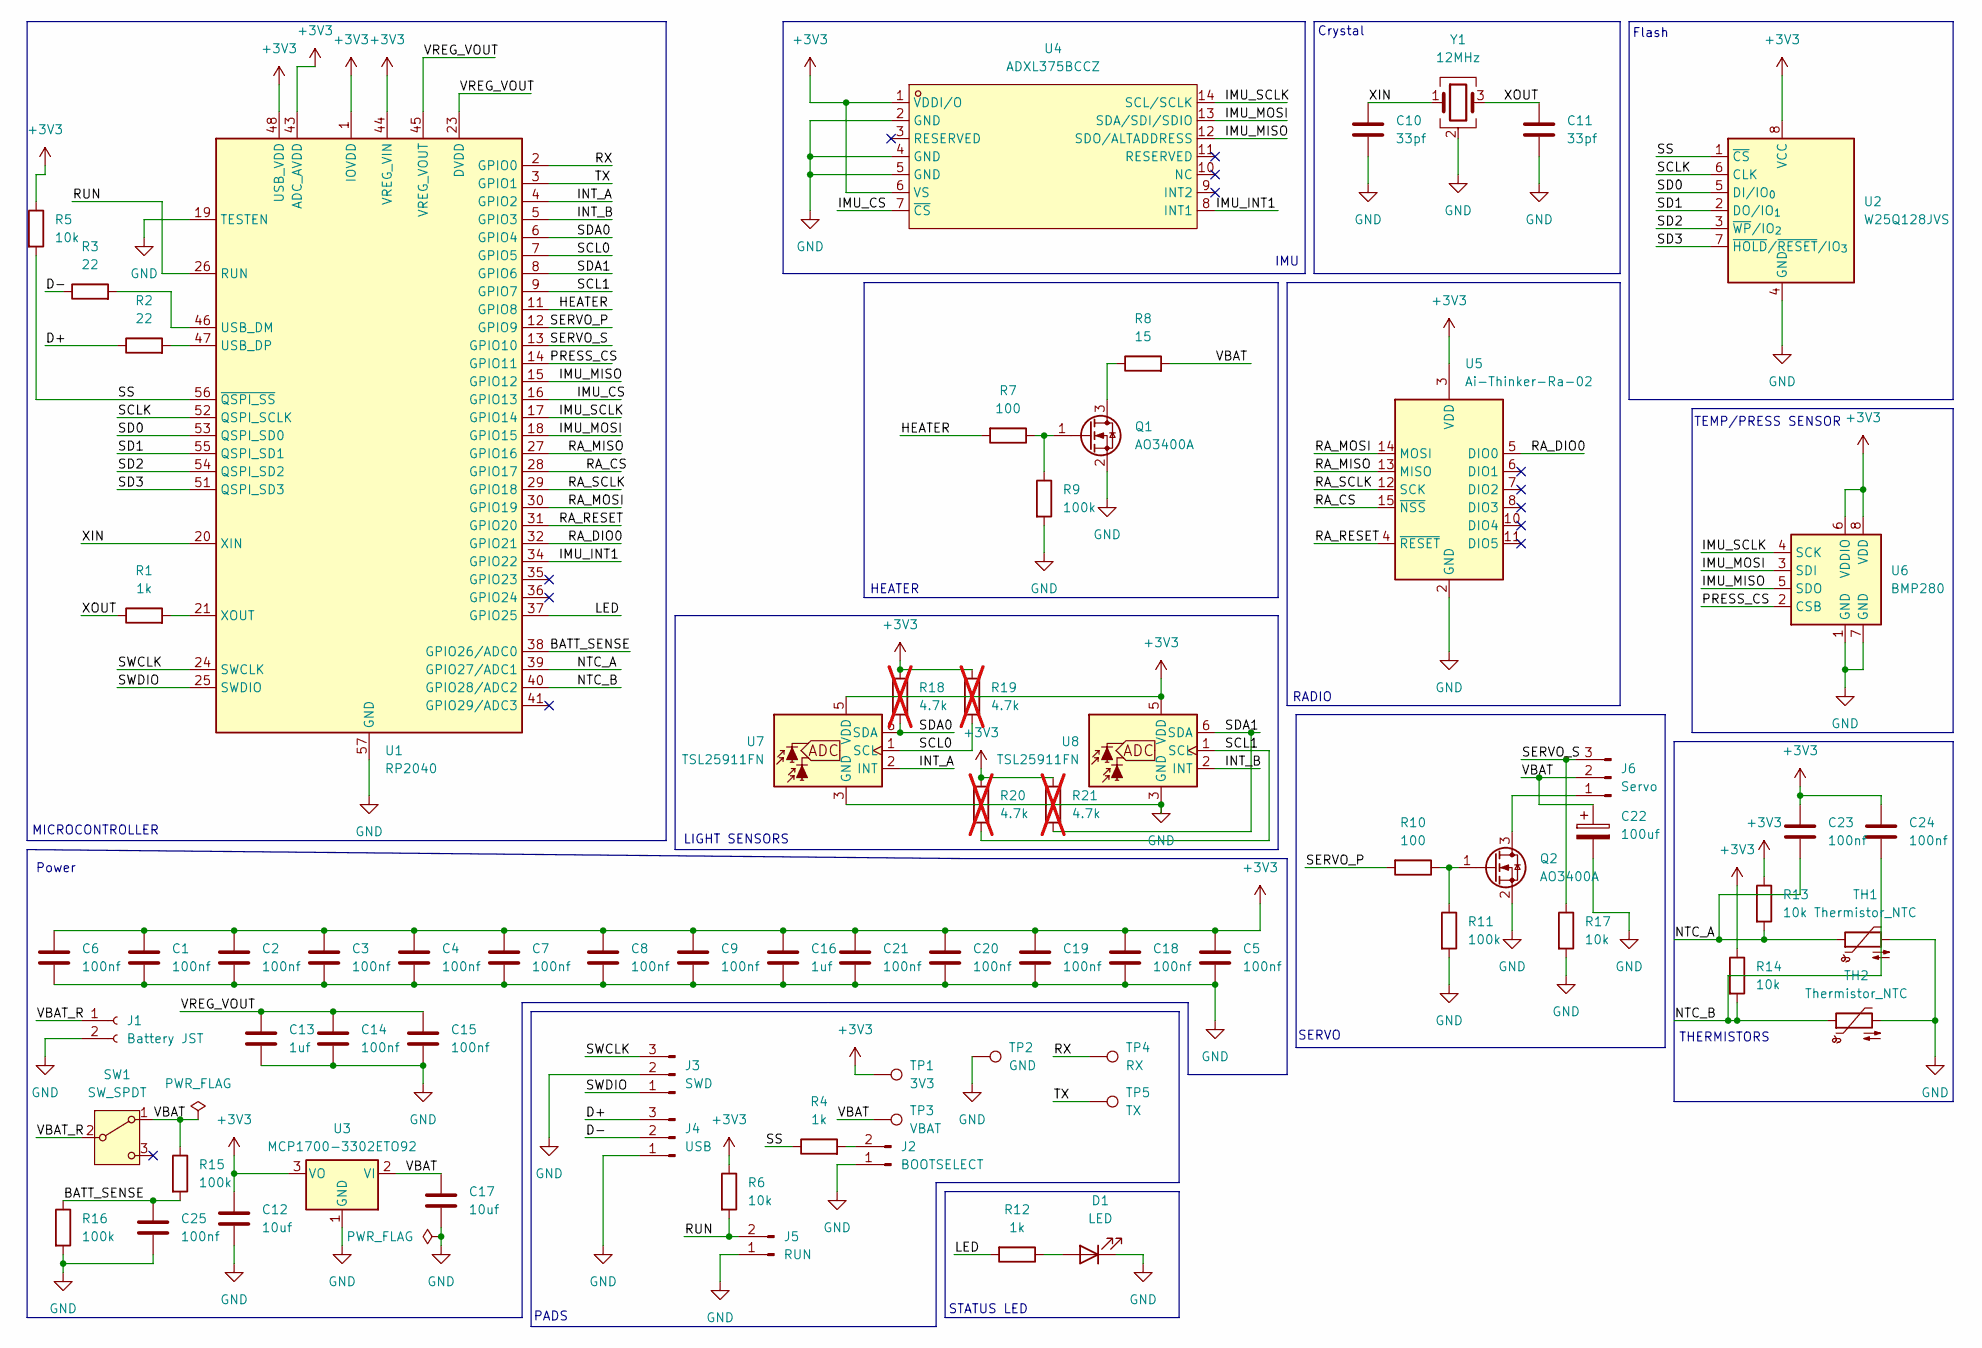
[picture p12: schematic CanSat.kicad_sch]

Parts:
C1, C2, C3, C4, C5, C6, C7, C8, C9, C14, C15, C18, C19, C20, C21, C23, C24, C25: 100nf; C_0402_1005Metric
C10, C11: 33pf; C_0402_1005Metric
C12, C17: 10uf; C_0603_1608Metric
C13, C16: 1uf; C_0402_1005Metric
C22: 100uf; CP_Radial_D5.0mm_P2.00mm
D1: LED; LED_0805_2012Metric
J1: Battery JST; JST_PH_B2B-PH-K_1x02_P2.00mm_Vertical
J2: BOOTSELECT; Pad_2pad_GND_SIG
J3: SWD; SWD_3pad
J4: USB; USB_3pad_wire
J5: RUN; Pad_2pad_GND_SIG
J6: Servo; Servo_3pad
Q1, Q2: AO3400A; SOT-23
R1, R4, R12: 1k; R_0402_1005Metric
R2, R3: 22; R_0402_1005Metric
R5, R6, R13, R14, R17: 10k; R_0402_1005Metric
R7, R10: 100; R_0402_1005Metric
R8: 15; Heater_2pad
R9, R11, R15, R16: 100k; R_0402_1005Metric
R18, R19, R20, R21: 4.7k; R_0402_1005Metric; not fitted
SW1: SW_SPDT; SW_SlideSwitch_3pad_wire
TH1, TH2: Thermistor_NTC; NTC_2pad
TP1: 3V3; TestPoint_Pad_D1.5mm
TP2: GND; TestPoint_Pad_D1.5mm
TP3: VBAT; TestPoint_Pad_D1.5mm
TP4: RX; TestPoint_Pad_D1.5mm
TP5: TX; TestPoint_Pad_D1.5mm
U1: RP2040; QFN-56-1EP_7x7mm_P0.4mm_EP3.2x3.2mm
U2: W25Q128JVS; SOIC-8_5.3x5.3mm_P1.27mm
U3: MCP1700-3302ETO92; TO-92_Inline
U4: ADXL375BCCZ; ADXL375_module_chippins; MPN ADXL375BCCZ; LCSC Part C579466
U5: Ai-Thinker-Ra-02; Ai-Thinker-Ra-01-LoRa
U6: BMP280; BMP280_module_chippins
U7, U8: TSL25911FN; TSL2591_module_chippins
Y1: 12MHz; Crystal_SMD_3225-4Pin_3.2x2.5mm

Connections:
+3V3: C1.1, C2.1, C3.1, C4.1, C5.1, C6.1, C7.1, C8.1, C9.1, C12.1, C16.1, C18.1, C19.1, C20.1, C21.1, C23.1, C24.1, R5.1, R6.1, R13.1, R14.1, R18.1, R19.1, R20.1, R21.1, TP1.1 (1_1), U1.1 (IOVDD), U1.10 (IOVDD), U1.22 (IOVDD), U1.33 (IOVDD), U1.42 (IOVDD), U1.43 (ADC_AVDD), U1.44 (VREG_VIN), U1.48 (USB_VDD), U1.49 (IOVDD), U2.8 (VCC), U3.3 (VO), U4.1 (VDDI/O), U4.6 (VS), U5.3 (VDD), U6.6 (VDDIO), U6.8 (VDD), U7.5 (VDD), U8.5 (VDD)
/BATT_SENSE: C25.1, R15.2, R16.1, U1.38 (GPIO26/ADC0)
/D+: J4.3, R2.1
/D-: J4.2, R3.1
/HEATER: R7.2, U1.11 (GPIO8)
/IMU_CS: U1.16 (GPIO13), U4.7 (~CS)
/IMU_INT1: U1.34 (GPIO22), U4.8 (INT1)
/IMU_MISO: U1.15 (GPIO12), U4.12 (SDO/ALTADDRESS), U6.5 (SDO)
/IMU_MOSI: U1.18 (GPIO15), U4.13 (SDA/SDI/SDIO), U6.3 (SDI)
/IMU_SCLK: U1.17 (GPIO14), U4.14 (SCL/SCLK), U6.4 (SCK)
/INT_A: U1.4 (GPIO2), U7.2 (INT)
/INT_B: U1.5 (GPIO3), U8.2 (INT)
/LED: R12.2, U1.37 (GPIO25)
/NTC_A: C23.2, R13.2, TH1.1, U1.39 (GPIO27/ADC1)
/NTC_B: C24.2, R14.2, TH2.1, U1.40 (GPIO28/ADC2)
/PRESS_CS: U1.14 (GPIO11), U6.2 (CSB)
/RA_CS: U1.28 (GPIO17), U5.15 (~NSS)
/RA_DIO0: U1.32 (GPIO21), U5.5 (DIO0)
/RA_MISO: U1.27 (GPIO16), U5.13 (MISO)
/RA_MOSI: U1.30 (GPIO19), U5.14 (MOSI)
/RA_RESET: U1.31 (GPIO20), U5.4 (~RESET)
/RA_SCLK: U1.29 (GPIO18), U5.12 (SCK)
/RUN: J5.2, R6.2, U1.26 (RUN)
/RX: TP4.1 (1_1), U1.2 (GPIO0)
/SCL0: R19.2, U1.7 (GPIO5), U7.1 (SCL)
/SCL1: R20.2, U1.9 (GPIO7), U8.1 (SCL)
/SCLK: U1.52 (QSPI_SCLK), U2.6 (CLK)
/SD0: U1.53 (QSPI_SD0), U2.5 (DI/IO_{0})
/SD1: U1.55 (QSPI_SD1), U2.2 (DO/IO_{1})
/SD2: U1.54 (QSPI_SD2), U2.3 (~WP/IO_{2})
/SD3: U1.51 (QSPI_SD3), U2.7 (~HOLD/~RESET/IO_{3})
/SDA0: R18.2, U1.6 (GPIO4), U7.6 (SDA)
/SDA1: R21.2, U1.8 (GPIO6), U8.6 (SDA)
/SERVO_P: R10.2, U1.12 (GPIO9)
/SERVO_S: J6.3, R17.1, U1.13 (GPIO10)
/SS: R4.1, R5.2, U1.56 (~QSPI_SS), U2.1 (~CS)
/SWCLK: J3.3, U1.24 (SWCLK)
/SWDIO: J3.1, U1.25 (SWDIO)
/TX: TP5.1 (1_1), U1.3 (GPIO1)
/VBAT: C17.1, C22.1, J6.2, R8.2, R15.1, SW1.1 (A), TP3.1 (1_1), U3.2 (VI)
/VBAT_R: J1.1, SW1.2 (B)
/VREG_VOUT: C13.1, C14.1, C15.1, U1.23 (DVDD), U1.45 (VREG_VOUT), U1.50 (DVDD)
/XIN: C10.1, U1.20 (XIN), Y1.1
/XOUT: C11.1, R1.1, Y1.3
GND: C1.2, C2.2, C3.2, C4.2, C5.2, C6.2, C7.2, C8.2, C9.2, C10.2, C11.2, C12.2, C13.2, C14.2, C15.2, C16.2, C17.2, C18.2, C19.2, C20.2, C21.2, C22.2, C25.2, D1.1 (K), J1.2, J2.1, J3.2, J4.1, J5.1, Q1.2 (S), Q2.2 (S), R9.2, R11.2, R16.2, R17.2, TH1.2, TH2.2, TP2.1 (1_1), U1.19 (TESTEN), U1.57 (GND), U2.4 (GND), U3.1 (GND), U4.2 (GND), U4.4 (GND), U4.5 (GND), U5.1 (GND), U5.2 (GND), U5.9 (GND), U5.16 (GND), U6.1 (GND), U6.7 (GND), U7.3 (GND), U8.3 (GND), Y1.2 (G), Y1.4 (G)
unnamed: D1.2 (A), R12.1
unnamed: J2.2, R4.2
unnamed: J6.1, Q2.3 (D)
unnamed: Q1.3 (D), R8.1
unnamed: Q1.1 (G), R7.1, R9.1
unnamed: Q2.1 (G), R10.1, R11.1
unnamed: R3.2, U1.46 (USB_DM)
unnamed: R2.2, U1.47 (USB_DP)
unnamed: R1.2, U1.21 (XOUT)

Notes on the sheet:
Power
Flash
HEATER
LIGHT SENSORS
MICROCONTROLLER
STATUS LED
PADS
Crystal
IMU
TEMP/PRESS SENSOR
THERMISTORS
SERVO
RADIO

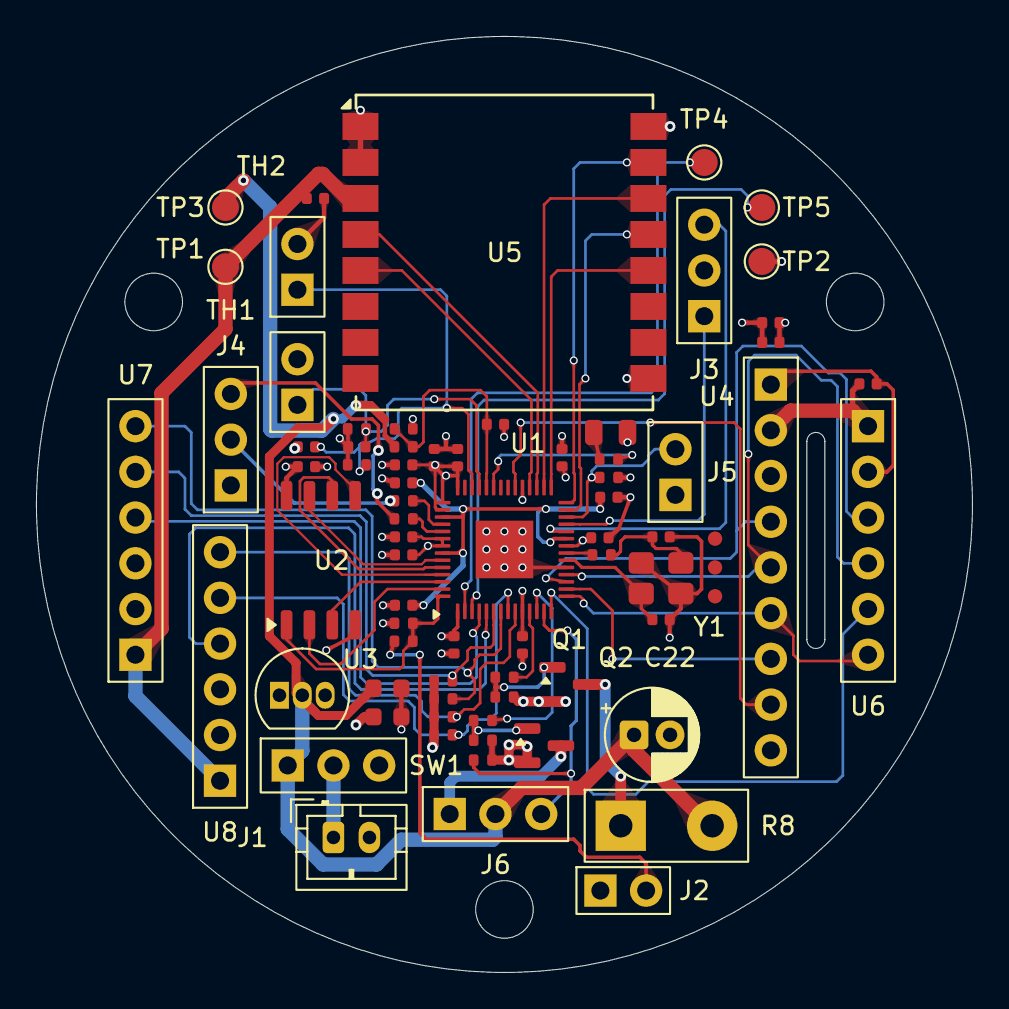
[picture p13: board CanSat.kicad_pcb from above]

Board: 4 copper layers, 52.0 x 52.0 mm, 75 parts (0 on the bottom side), 54 nets.

Other parts of the board:
H1, H2, H3: M3_TieRod; MountingHole_3.2mm_M3
