huzi-ctrl/Verticality/(commit log)

2026-11-08 Complete 4-layer RP2040 CanSat PCB (45-deg mitered routing, 0 DRC errors), Gerbers, STEP, firmware, and Hack Club Half-Life README
    [CanSat-B_Cu.gbl, CanSat-B_Mask.gbs, CanSat-B_Paste.gbp, CanSat-B_Silkscreen.gbo, CanSat-Edge_Cuts.gm1, CanSat-F_Cu.gtl, CanSat-F_Mask.gts, CanSat-F_Paste.gtp]
2026-11-08 Add pcb/ folder for KiCanvas badge and update README for Hack Club Shipping 101
    [CanSat.kicad_pcb, CanSat.kicad_sch, bom.csv]
2026-11-08 Set exclude flags on non-SMT footprints, change J2 to Pad_2pad_GND_SIG, and add 0.6/0.3 GND vias to Q1/Q2
    [CanSat.kicad_pcb, CanSat.kicad_sch, CanSat.step, positions_jlcpcb.csv]
2026-11-08 Remove CAD files while keeping firmware
    [CanSat.step]
2026-11-08 Align PCB, schematic, JLCPCB/repo BOMs, firmware, DRC report, and README with PDR v2 and Design Guide Rev 2
    [CanSat-B_Cu.gbl, CanSat-B_Mask.gbs, CanSat-B_Paste.gbp, CanSat-B_Silkscreen.gbo, CanSat-Edge_Cuts.gm1, CanSat-F_Cu.gtl, CanSat-F_Mask.gts, CanSat-F_Paste.gtp]
2026-11-08 Relocate J2 clear of H1 washer keepout, enforce keepout in kicad_dru, and update production gerbers and renders
    [CanSat.kicad_pcb]
2026-11-08 Update via drills to 0.3mm, relax annular ring to 0.075mm, refill zones, and regenerate gerbers
    [CanSat.kicad_pcb]
2026-11-08 Update refilled teardrop zones in CanSat.kicad_pcb
    [CanSat.kicad_pcb]
2026-11-08 Update README to accurately document DRC report, 0.3mm via sizing, and JLCPCB 4-layer CAM clearances
2026-11-08 format project bom for hack club halflife in usd and upload BOM.csv
    [BOM.csv, bom.csv]
2026-11-08 use lowercase bom for all references outside BOM.csv
    [CanSat_bom_verified_direct_links_2 (1).xlsx, CanSat_schematic_to_bom_map.csv]
2026-11-08 revert renaming of other BOM files (CanSat_schematic_to_BOM_map.csv and CanSat_BOM_verified_direct_links_2)
    [CanSat_BOM_verified_direct_links_2 (1).xlsx, CanSat_schematic_to_BOM_map.csv]
2026-11-08 ensure BOM.csv is the only file with bom in its filename
    [CanSat_parts_verified_direct_links.xlsx, CanSat_schematic_to_parts_map.csv, parts_jlcpcb.csv]
2026-11-08 format BOM.csv to match Hack Club importer schema (Item,Qty,Supplier,Cost/item,Total Cost,link)
    [BOM.csv]
